adriaanbakker-java/Thermostaatcontroller/thermostaatcontroller aansluitingen.jpg

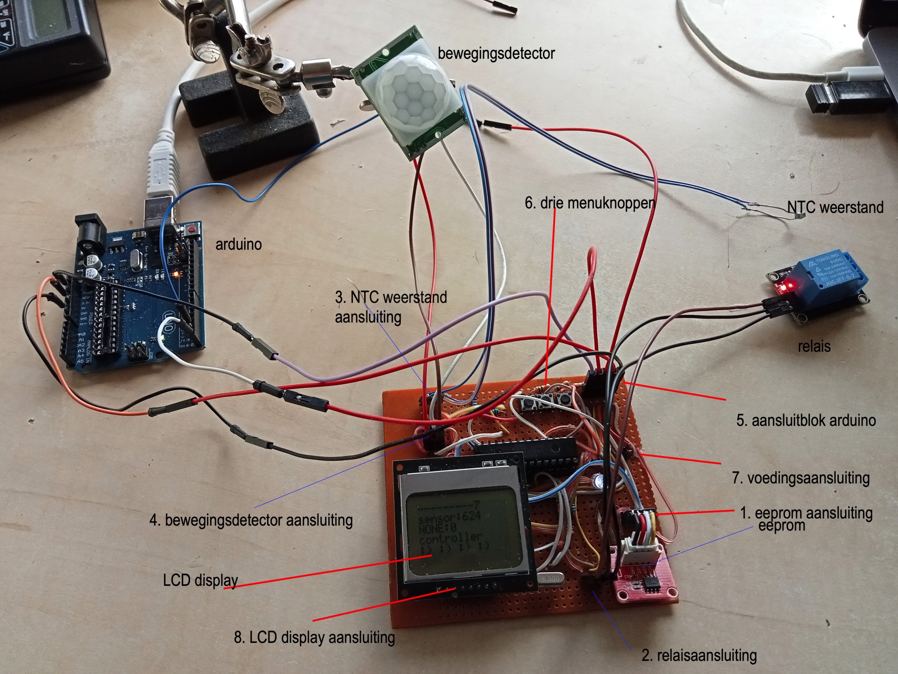
thermostaatcontroller aansluitingen.jpg
