adriaanbakker-java/Thermostaatcontroller/thermostaatcontroller.jpg

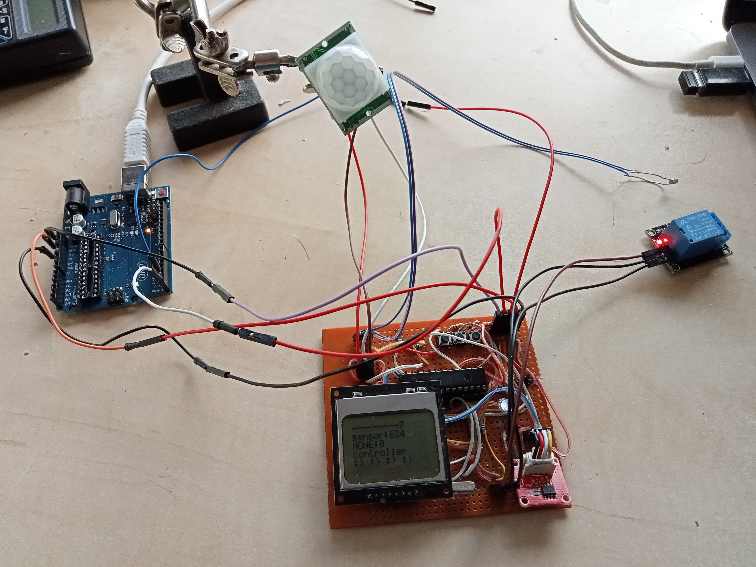
thermostaatcontroller.jpg
