adriaanbakker-java/Thermostaatcontroller/Thermostaat/Thermostaat.brd

## EAGLE design Thermostaat/Thermostaat.brd (2023-02-05)

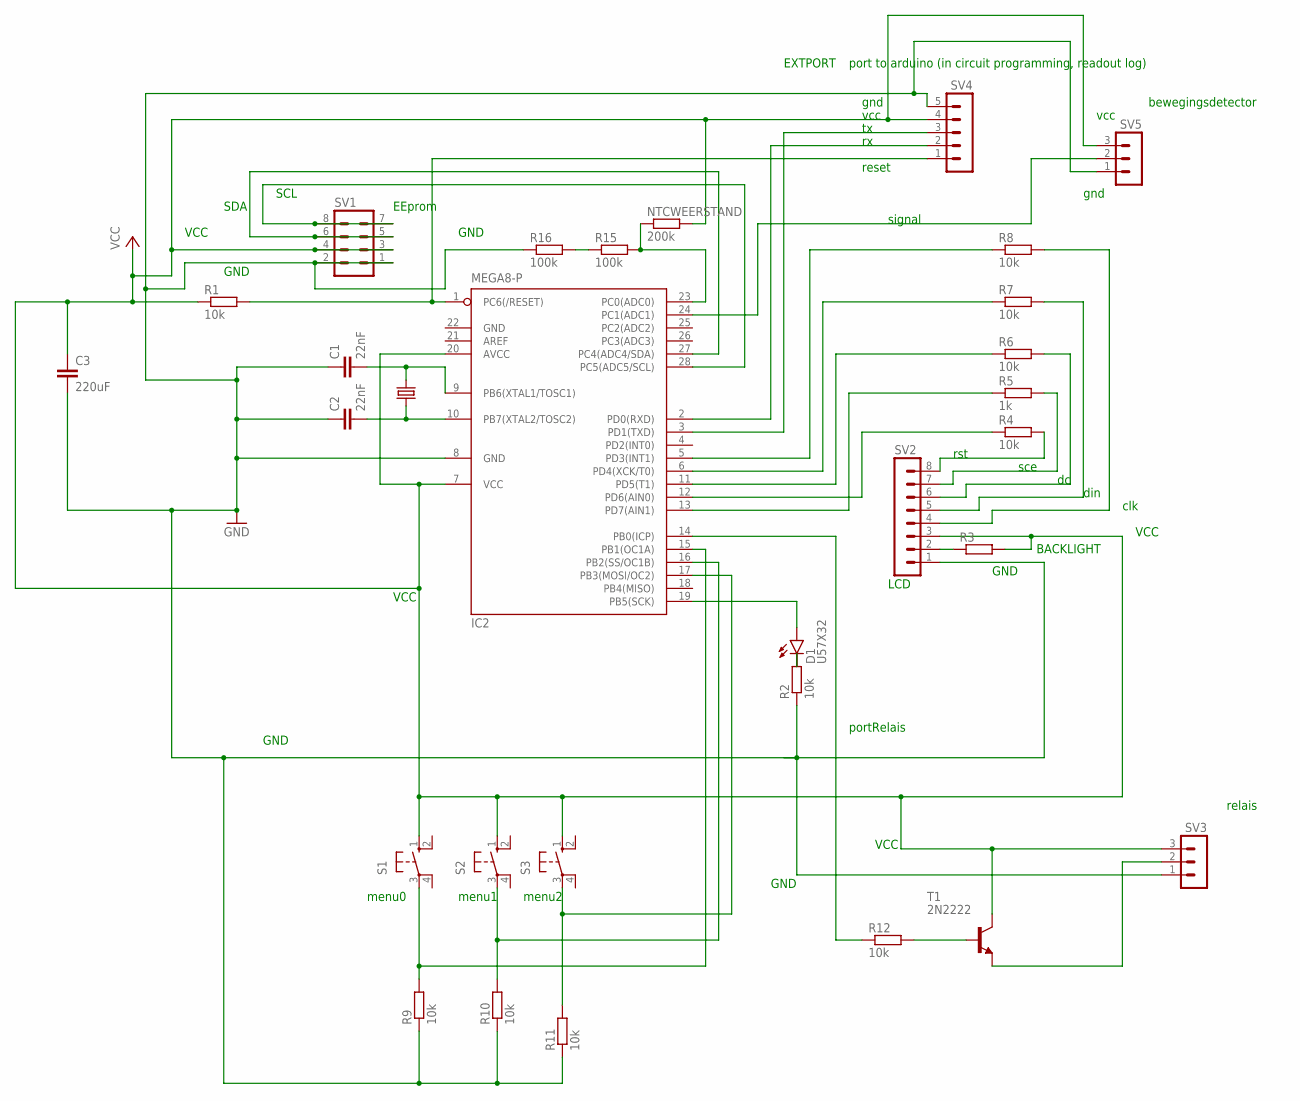
[picture p15: schematic Thermostaat.sch]

Parts:
C1, C2: 22nF; C2.5-2
C3: 220uF; C5B5.5
D1: U57X32
IC2: MEGA8-P; DIL28-3
NTCWEERSTAND: 200k; 0204/7
Q1: CRYSTALHC49U-V; HC49U-V
R1, R2, R4, R6, R7, R8, R9, R10, R11, R12: 10k; 0204/7
R3: R-EU_0204/7; 0204/7
R5: 1k; 0204/7
R15, R16: 100k; 0204/7
S1, S2, S3: 10-XX; B3F-10XX
SV1: MA04-2
SV2: MA08-1
SV3, SV5: MA03-1
SV4: MA05-1
T1: 2N2222; TO18

Connections:
GND: C1.1, C2.1, C3.2, IC2.8 (GND), IC2.22 (GND), R2.1, R9.1, R10.1, R11.1, R16.1, SV1.1, SV1.2, SV2.1, SV3.1, SV4.5, SV5.1
unnamed: IC2.1 (PC6(/RESET)), R1.2, SV4.1
unnamed: C2.2, IC2.10 (PB7(XTAL2/TOSC2)), Q1.2
unnamed: C1.2, IC2.9 (PB6(XTAL1/TOSC1)), Q1.1
unnamed: IC2.28 (PC5(ADC5/SCL)), SV1.7, SV1.8
unnamed: IC2.24 (PC1(ADC1)), SV5.2
unnamed: D1.A, IC2.19 (PB5(SCK))
unnamed: D1.K (C), R2.2
unnamed: R3.1, SV2.2
unnamed: R8.2, SV2.4
unnamed: R7.2, SV2.5
unnamed: R6.2, SV2.6
unnamed: R5.2, SV2.7
unnamed: R4.2, SV2.8
unnamed: IC2.5 (PD3(INT1)), R8.1
unnamed: IC2.6 (PD4(XCK/T0)), R7.1
unnamed: IC2.11 (PD5(T1)), R6.1
unnamed: IC2.13 (PD7(AIN1)), R5.1
unnamed: SV3.2, T1.1 (E)
unnamed: R12.2, T1.2 (B)
unnamed: IC2.14 (PB0(ICP)), R12.1
unnamed: IC2.12 (PD6(AIN0)), R4.1
unnamed: IC2.2 (PD0(RXD)), SV4.2
unnamed: IC2.3 (PD1(TXD)), SV4.3
unnamed: IC2.17 (PB3(MOSI/OC2)), R11.2, S3.3
unnamed: IC2.16 (PB2(SS/OC1B)), R10.2, S2.3
unnamed: IC2.15 (PB1(OC1A)), R9.2, S1.3
unnamed: R15.1, R16.2
unnamed: IC2.23 (PC0(ADC0)), NTCWEERSTAND.1, R15.2
SCL: IC2.27 (PC4(ADC4/SDA)), SV1.5, SV1.6
VCC: C3.1, IC2.7 (VCC), IC2.20 (AVCC), NTCWEERSTAND.2, R1.1, R3.2, S1.1 (S), S2.1 (S), S3.1 (S), SV1.3, SV1.4, SV2.3, SV3.3, SV4.4, SV5.3, T1.3 (C)

Notes on the sheet:
EEprom
GND
VCC
SDA
SCL
BACKLIGHT
LCD
clk
din
sce
relais
portRelais
rst
EXTPORT
port to arduino (in circuit programming, readout log)
reset
vcc
gnd
menu0
menu1
menu2
bewegingsdetector
signal

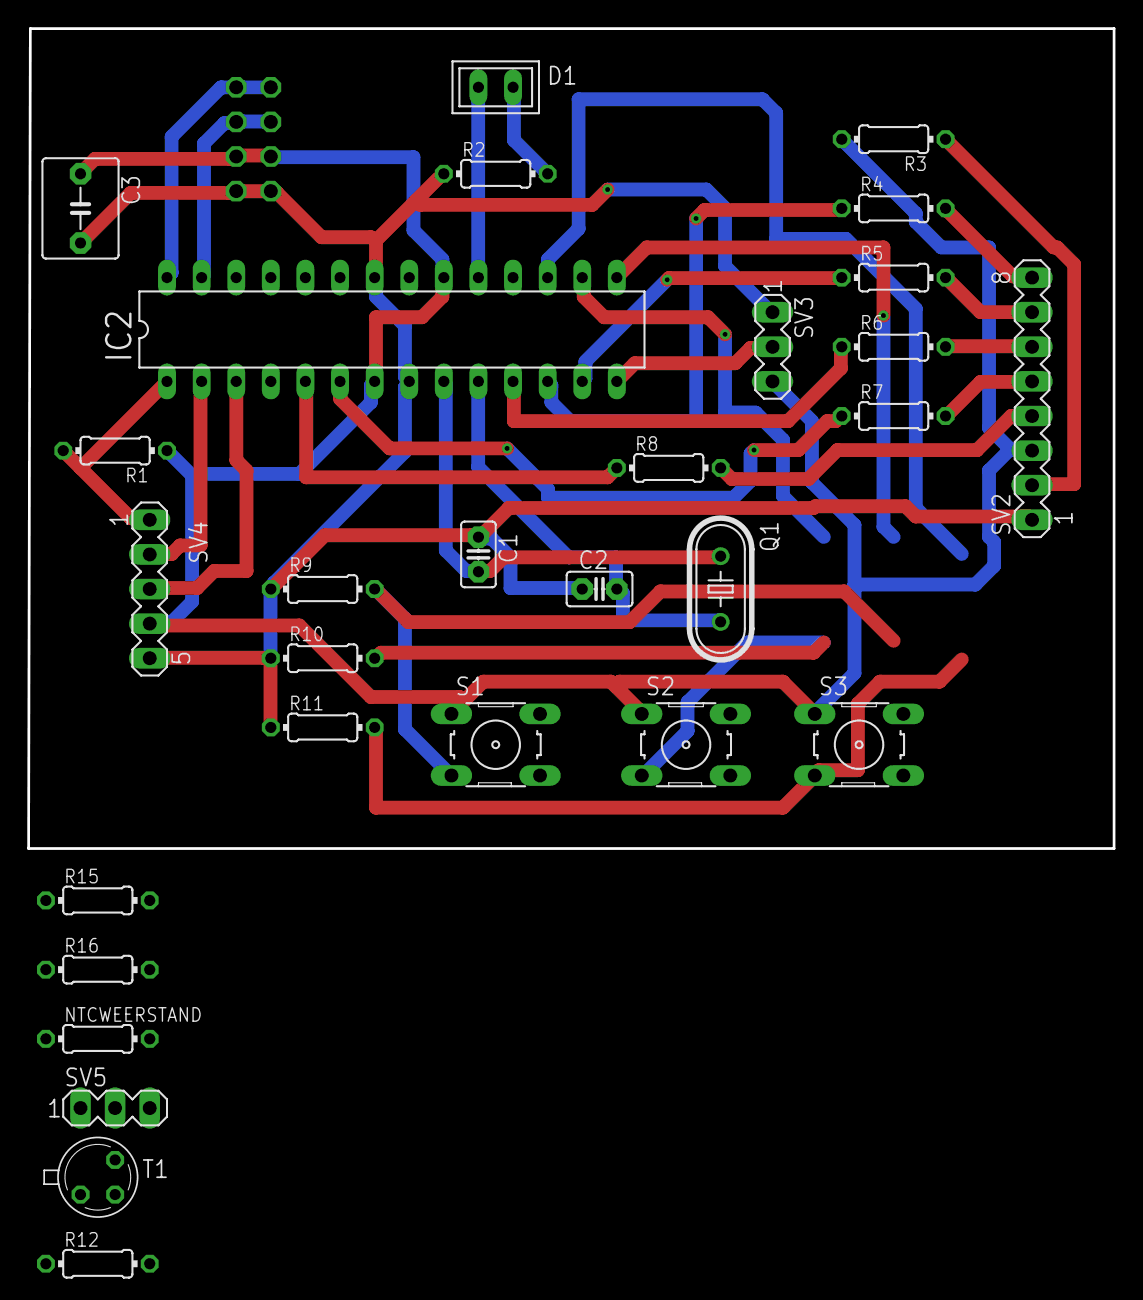
[picture p16: board Thermostaat.brd from above]

Board: 2 copper layers, 79.7 x 60.2 mm, 30 parts (1 on the bottom side), 31 nets.
