adriaanbakker-java/Thermostaatcontroller/Thermostaat002/AT24C256.h

#ifndef AT24C256_h
#define AT24C256_h

#include "Arduino.h"
#include "Wire.h"

class AT24C256
{
public: 
    AT24C256(int address, TwoWire *twi);
    void begin(void);
    void write(uint16_t writeAddress, uint8_t* data, uint8_t len);
    void read(uint16_t readAddress, uint8_t* data, uint8_t len);

private:
    int _address;
    TwoWire *_twi;
};

#endif
