adriaanbakker-java/Thermostaatcontroller/(commit log)

2023-02-05 transistor toegevoegd voor relais
    [Thermostaat.brd, Thermostaat.sch]
2023-02-05 kachel class opnieuw, gaf wat problemen
    [AT24C256.cpp, AT24C256.h, Kachel.cpp, Kachel.h, Thermostaat002.ino]
2023-02-06 temperaturen bijstellen
2023-02-06 temperaturen verstellen
2023-02-08 poort A1 vervangen door A2
    [instellen-parrameters-ntc.xlsx]
